mystster/kleinpad/README.md

# kleinpad
This is a small, self-made keyboard with a limited number of keys, designed by mystster.
