mystster/kleinpad/kleinpad v1.dxf

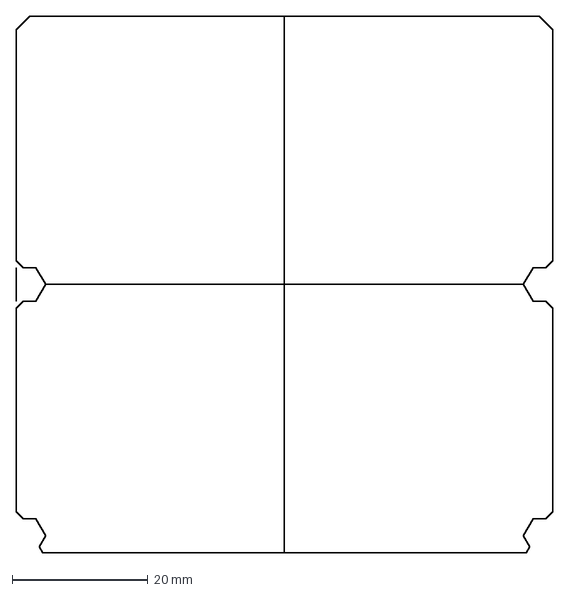
[picture p1: CAD file, 2025-08-16]
kleinpad v1.dxf
79.0 x 79.0 mm
