mystster/kleinpad/kleinpad_outline-Edge_Cuts.dxf

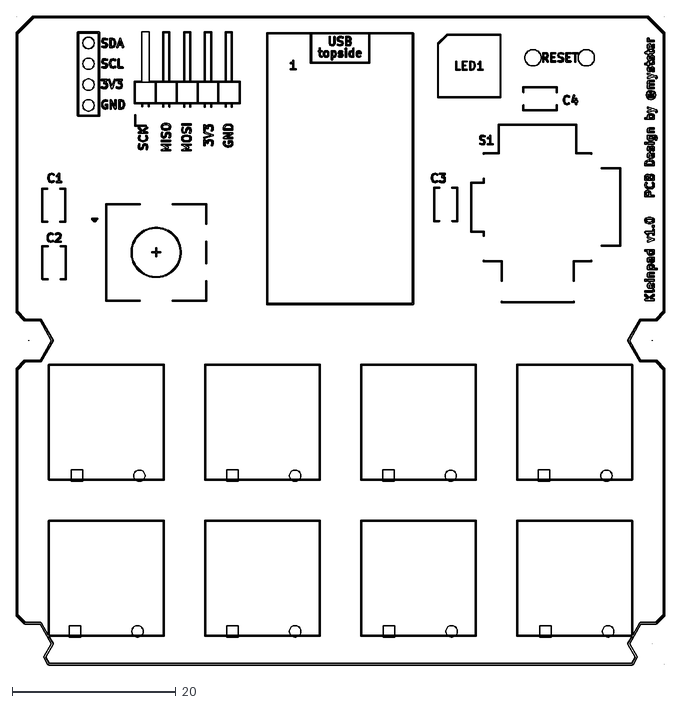
[picture p2: CAD file, 2025-08-16]
kleinpad_outline-Edge_Cuts.dxf
79.2 x 79.2
