mystster/kleinpad/kleinpad.kicad_pcb

## KiCad design kleinpad.kicad_pcb (2025-08-22)

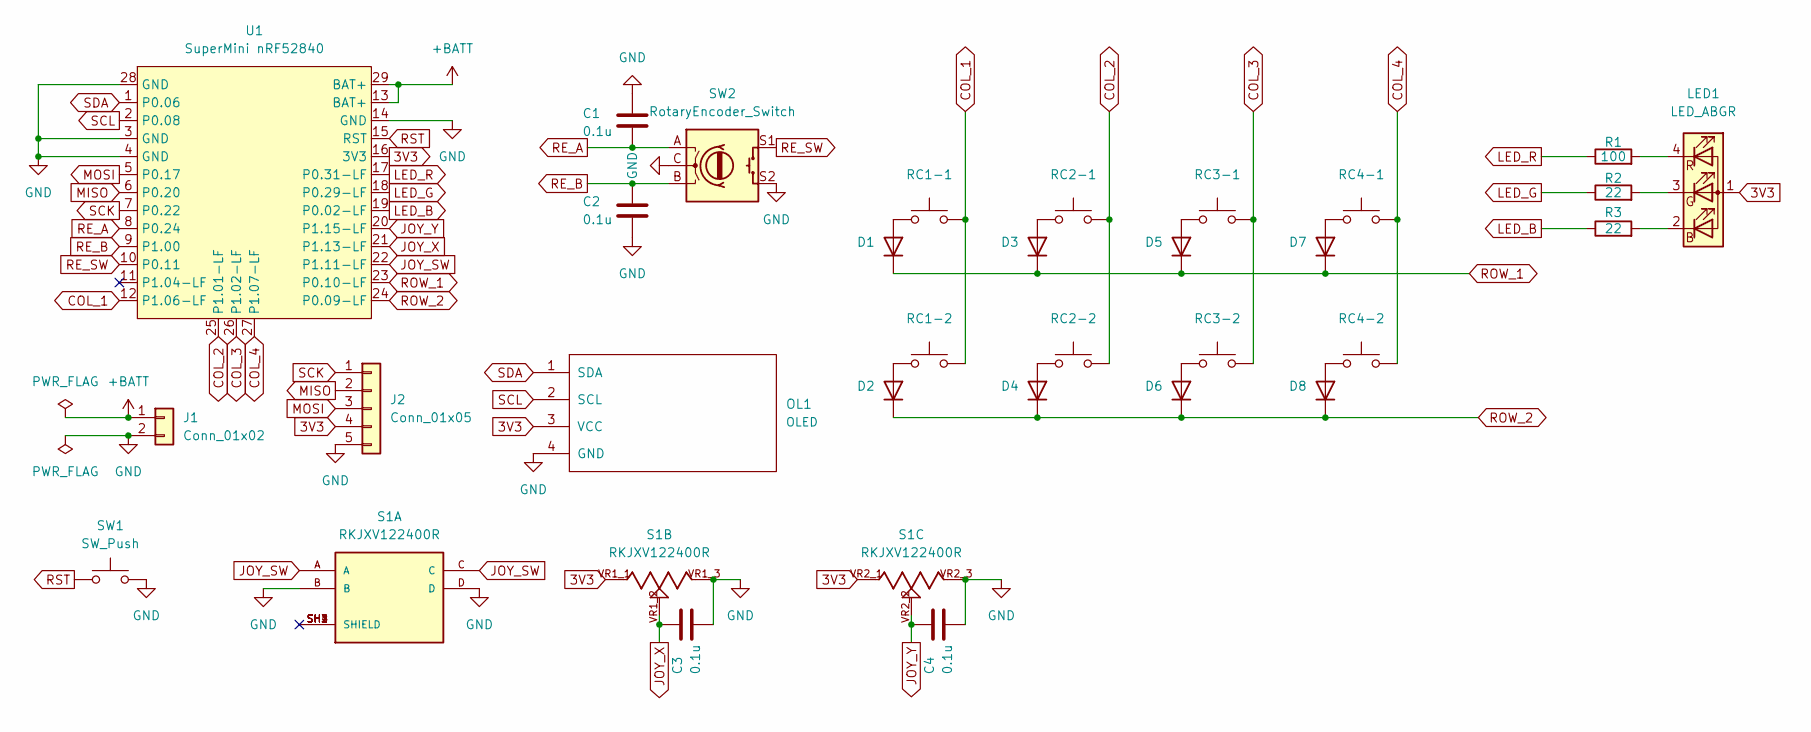
[picture p3: schematic kleinpad.kicad_sch]

Parts:
C1, C2, C3, C4: 0.1u; C_Disc_D3.8mm_W2.6mm_P2.50mm
D1, D2, D3, D4, D5, D6, D7, D8: 1N4148; Diode_TH_SMD
J1: Conn_01x02; JST_PH_S2B-PH-K_1x02_P2.00mm_Horizontal
J2: Conn_01x05; PinHeader_1x05_P2.54mm_Horizontal
LED1: LED_ABGR; LED Rectangle(OSTBMAZ2C1D)
OL1: OLED
R1: 100; Resistor-Compact-1-side
R2, R3: 22; Resistor-Compact-1-side
RC1-1, RC1-2, RC2-1, RC2-2, RC3-1, RC3-2, RC4-1, RC4-2: SW_Push; CherryMX_Hotswap_1u
S1: RKJXV122400R; SW_RKJXV122400R; PARTREV N/A
SW1: SW_Push; ResetSW
SW2: RotaryEncoder_Switch; RotaryEncoder_EC11
U1: SuperMini nRF52840; SuperMini_nRF52840_AH_USBup

Connections:
3V3: J2.4, LED1.1 (A), OL1.3 (VCC), S1.VR1_1, S1.VR2_1, U1.16 (3V3)
+BATT: J1.1, U1.13 (BAT+), U1.29 (BAT+)
COL_1: RC1-1.1, RC1-2.1, U1.12 (P1.06-LF)
COL_2: RC2-1.1, RC2-2.1, U1.25 (P1.01-LF)
COL_3: RC3-1.1, RC3-2.1, U1.26 (P1.02-LF)
COL_4: RC4-1.1, RC4-2.1, U1.27 (P1.07-LF)
GND: C1.1, C2.2, C3.2, C4.2, J1.2, J2.5, OL1.4 (GND), S1.B, S1.D, S1.VR1_3, S1.VR2_3, SW1.2, SW2.C, SW2.S2, U1.3 (GND), U1.4 (GND), U1.14 (GND), U1.28 (GND)
JOY_SW: S1.A, S1.C, U1.22 (P1.11-LF)
JOY_X: C3.1, S1.VR1_2, U1.21 (P1.13-LF)
JOY_Y: C4.1, S1.VR2_2, U1.20 (P1.15-LF)
LED_B: R3.1, U1.19 (P0.02-LF)
LED_G: R2.1, U1.18 (P0.29-LF)
LED_R: R1.1, U1.17 (P0.31-LF)
MISO: J2.2, U1.6 (P0.20)
MOSI: J2.3, U1.5 (P0.17)
unnamed: D1.2 (A), RC1-1.2
unnamed: D2.2 (A), RC1-2.2
unnamed: D3.2 (A), RC2-1.2
unnamed: D4.2 (A), RC2-2.2
unnamed: D5.2 (A), RC3-1.2
unnamed: D6.2 (A), RC3-2.2
unnamed: D7.2 (A), RC4-1.2
unnamed: D8.2 (A), RC4-2.2
unnamed: LED1.2 (BK), R3.2
unnamed: LED1.3 (GK), R2.2
unnamed: LED1.4 (RK), R1.2
RE_A: C1.2, SW2.A, U1.8 (P0.24)
RE_B: C2.1, SW2.B, U1.9 (P1.00)
RE_SW: SW2.S1, U1.10 (P0.11)
ROW_1: D1.1 (K), D3.1 (K), D5.1 (K), D7.1 (K), U1.23 (P0.10-LF)
ROW_2: D2.1 (K), D4.1 (K), D6.1 (K), D8.1 (K), U1.24 (P0.09-LF)
RST: SW1.1, U1.15 (RST)
SCK: J2.1, U1.7 (P0.22)
SCL: OL1.2 (SCL), U1.2 (P0.08)
SDA: OL1.1 (SDA), U1.1 (P0.06)

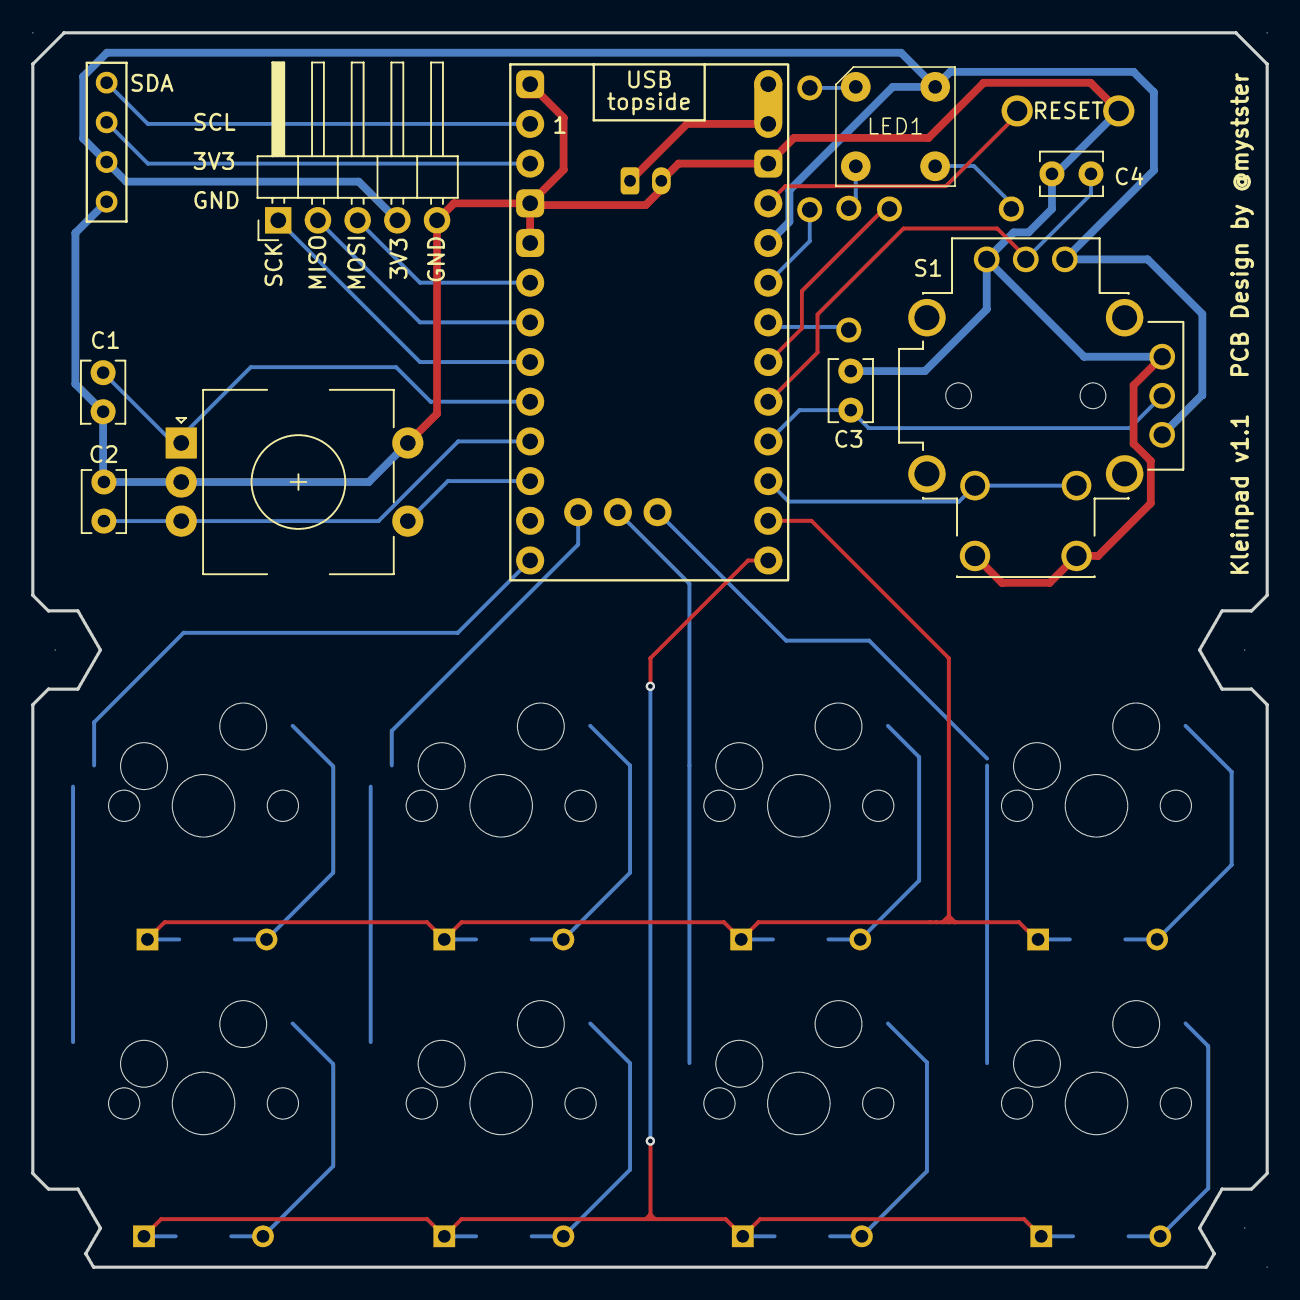
[picture p4: board kleinpad.kicad_pcb from above]

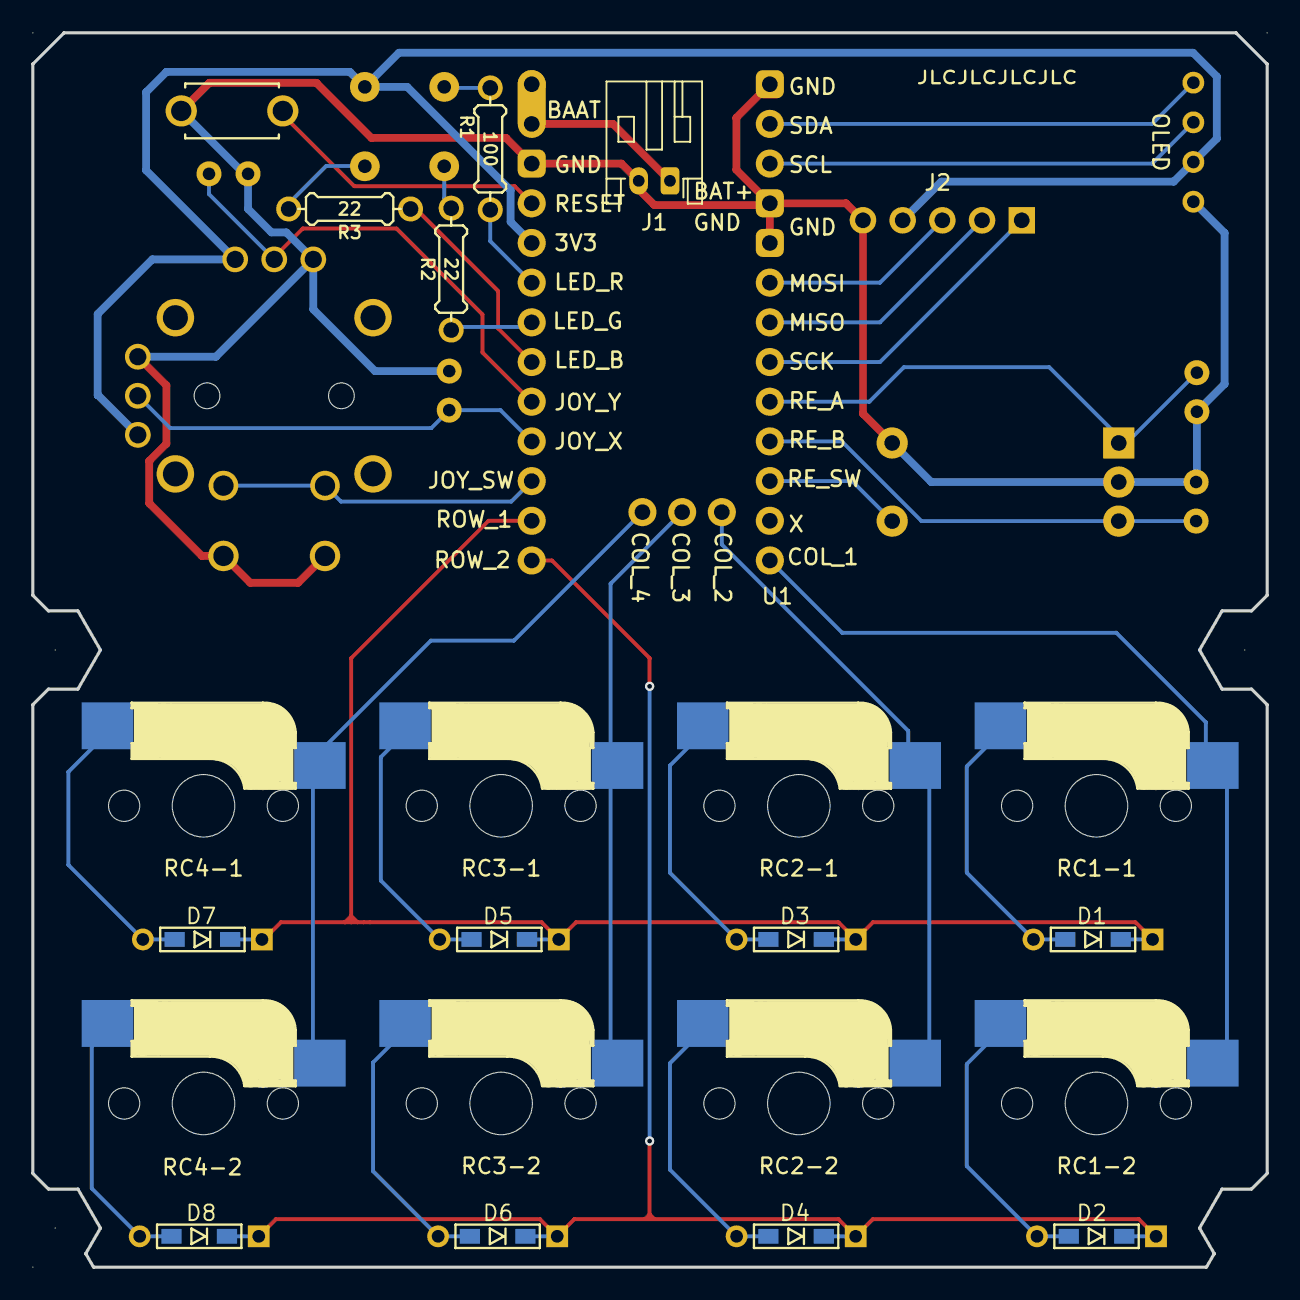
[picture p5: board kleinpad.kicad_pcb from below]

Board: 2 copper layers, 79.0 x 79.0 mm, 31 parts (4 on the bottom side), 35 nets.
