mystster/kleinpad/(threads)

Thread 1 (2025-08-04):

バッテリーコネクタが接続できない

mystster, 2025-08-04:
バッテリーのコネクタが、Superminiのコネクタと干渉して刺さらない気がする。
<!-- 新しいイシューの本文を編集し、エディターの右上にある ✓ [イシューの作成] ボタンをクリックします。最初の行がイシューのタイトルになります。担当者とラベルは空白行の後に続きます。イシューの本文を開始する前に空の行を残します。 -->

mystster, 2025-08-05:
USB-Cと同じ方向（上向き）が良さそう。
右と左は今と同じ状況、下は3ピンあるので邪魔そうなので。

Closed 2025-08-16.

Thread 3 (2025-08-04):

ダイオードのスルーホールがキースイッチに干渉する

mystster, 2025-08-04:
ダイオードのスルーホールがちょうどキースイッチ下部端と干渉しているため、スルーホールでの実装ができない。
実装すると、キースイッチが差し込めない。

<!-- 新しいイシューの本文を編集し、エディターの右上にある ✓ [イシューの作成] ボタンをクリックします。最初の行がイシューのタイトルになります。担当者とラベルは空白行の後に続きます。イシューの本文を開始する前に空の行を残します。 -->
