mystster/kleinpad/(commit log)

2025-06-28 feat: Add initial KiCad schematic and PCB project files
    Introduces the foundational schematic, PCB layout, and project configuration for the new hardware design. Enables schematic capture, layout, and build processes in KiCad for future hardware development and iteration.
    [kleinpad.kicad_pcb, kleinpad.kicad_sch]
2025-06-29 feat: add pcb
    [kleinpad.kicad_pcb, kleinpad.kicad_sch]
2025-08-03 feat: 回路図を追加
    [kleinpad.kicad_pcb, kleinpad.kicad_sch]
2025-08-03 feat: JLCPCBへ発注
    [kleinpad-B_Cu.gbr, kleinpad-B_Mask.gbr, kleinpad-B_Silkscreen.gbr, kleinpad-Edge_Cuts.gbr, kleinpad-F_Cu.gbr, kleinpad-F_Mask.gbr, kleinpad-F_Silkscreen.gbr, kleinpad-NPTH-drl_map.gbr]
2025-08-16 fix: LEDに抵抗がない
    抵抗値は手元にあるものに合わせて変更
    Fixes #2
    [kleinpad.kicad_pcb, kleinpad.kicad_sch]
2025-08-16 feat: 3Dプリンタ用STL作成用のファイルを追加
    [kleinpad v1.dxf, kleinpad_outline-Edge_Cuts.dxf, kleinpad_outline.kicad_pcb]
2025-08-16 fix: .gitignoreにバックアップファイルのパターンを追加
2025-08-16 feat: JLCPCBへ1回目の発注を行ったファイル
2025-08-16 fix: バッテリーコネクタが接続できない Fixes #1
    commit: 14f930df53bbbcb42010b72f48aa18af7e7124dd で修正済みだった
    [kleinpad.kicad_pcb]
2025-08-16 fix: 抵抗周りの配線のレイアウトを変更
    [kleinpad.kicad_pcb]
2025-08-16 fix: 未接続の配線を接続
    [kleinpad.kicad_pcb]
2025-08-16 feat: bump version
    [kleinpad.kicad_pcb]
2025-08-22 fix: OLEDとSuperMiniの干渉 Fixes #4
    [kleinpad.kicad_pcb]
2025-08-22 fix: ダイオードのスルーホールがキースイッチに干渉する Fixes #3
    [kleinpad.kicad_pcb]
2025-08-22 chore: bump version
    [kleinpad.kicad_pcb]
2025-08-22 feat: add jlc order place
    [kleinpad.kicad_pcb]
2025-08-22 fix: 配線を少しだけ変更
    [kleinpad.kicad_pcb]
